AhmedShadeed/D-Serviss-Solder/Foto.jpg

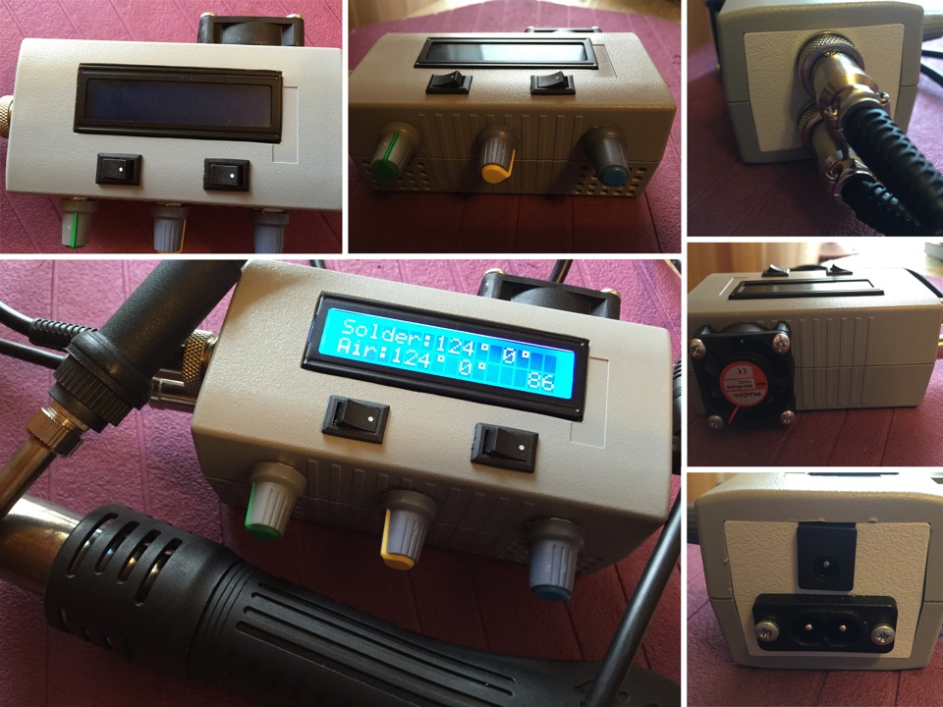
Foto.jpg
