AhmedShadeed/D-Serviss-Solder/README.md

# Мини паяльная станция с феном на Atmega328
Мини паяльная станция в корпусе G412 (120х60х50 мм). За основу был взят проект http://www.youtube.com/watch?v=wzGbTwlyZxo. Схема предельно простая, без особых "обвязок", но что самое главное — рабочая.

Немного переделал плату. Выкинул кренки L7805 и L7812, т.к. они сильно грелись и вместо них поставил китайские мини DC-DC конвертеры (на LM2596). С них получаю +5В для питания схемы и +12В для вентилятора фена. Так же заменил MOSFET на более быструю IRL-серию (хотя для вентилятора фена можно было оставить и IRF). Вентилятор охлаждения теперь можно не использовать (остался от версии с кренками). Так же в скетч была добавлена функция усреднения получаемых значений. Это уменьшило "дребезг" цифр дисплея.

Питается это все от ноутбучного 19В (96Вт) блока питания, а также есть вход 220В для нагревателя фена который подключается по мере необходимости пользования.

#### Список деталей
* Микроконтроллёр: Atmega328p
* Экран: LCD1602
* ОУ: LM358
* Опторазвязка: MOC3063
* Мосфет: IRLZ44N (2 шт.)
* Симистор: BT138
* Mini 3A DC-DC Adjustable Step-down Converter LM2596 (2 шт.)
* Потенциометр: 10К (3 шт.)
* Подстроечный резистор: 10К (3 шт.)
* Резистор: 22К
* Светодиод: 2.5 мм, 20мА (2 шт.)
* Резонатор: 16 Мгц
* SMD резистор: 220 (2 шт.)
* SMD резистор: 10К (4 шт.)
* SMD резистор: 220К (2 шт.)
* SMD конденсатор: 1 мкф (3 шт.)
* Переключатель: (2 шт.)
* Гнездо: GX16-8
* Гнездо:GX16-5
* Паяльник на 24В с К-термопарой
* Фен с встроенным вентилятором с К-термопарой

#### Фото
BMW E83 Nexus 7

#### Ссылки на детали:
* http://goo.gl/576kv2 Микроконтроллёр Atmega328p
* http://goo.gl/MfbdVJ Экран LCD1602
* http://goo.gl/TlrkPB Мосфет IRLZ44N
* http://goo.gl/xQJfL0 Mini 3A DC-DC
* http://goo.gl/uFLEhE Гнездо GX16-8
* http://goo.gl/IooguI Гнездо GX16-5
* http://goo.gl/GKu0w1 Паяльный фен
* http://goo.gl/fS1MvT Паяльник A1322. Если есть ручка с терморезистором (A1321), то можно поставить нагреватель с термопарой: http://goo.gl/H9yyfF

Группа в VK: http://vk.com/WhatWouldSolder. Что бы Такого Спаять?

По всем вопросам: info@phpscript.ru
