AhmedShadeed/D-Serviss-Solder/Scheme.jpg

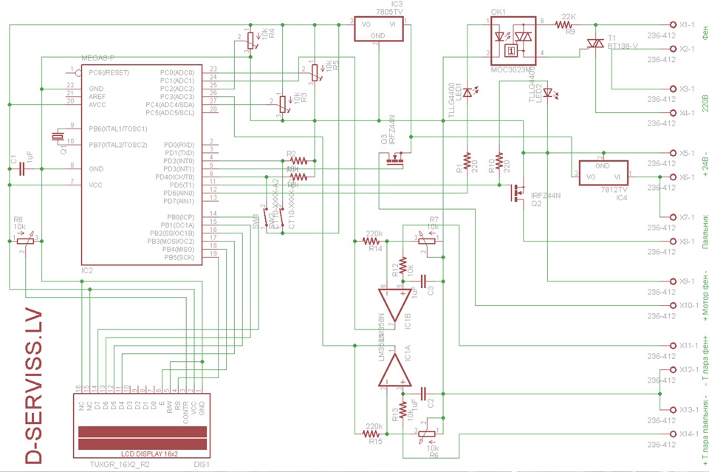
Scheme.jpg
