AhmedShadeed/D-Serviss-Solder/(list of files, drawings)

Other design files:
PCB.lay6
