AhmedShadeed/D-Serviss-Solder/(commit log)

2017-06-20 Добавление фото
2018-01-30 Правка описания
2019-02-23 Изменен README.md
